epsi-workshop/server-backend/README.md

# server-backend
(Python ou C++) : API REST / WebSockets / gRPC, modèles d'IA, logique métier, requêtes base de données.
