epsi-workshop/server-backend/enclosure/stl/back.stl

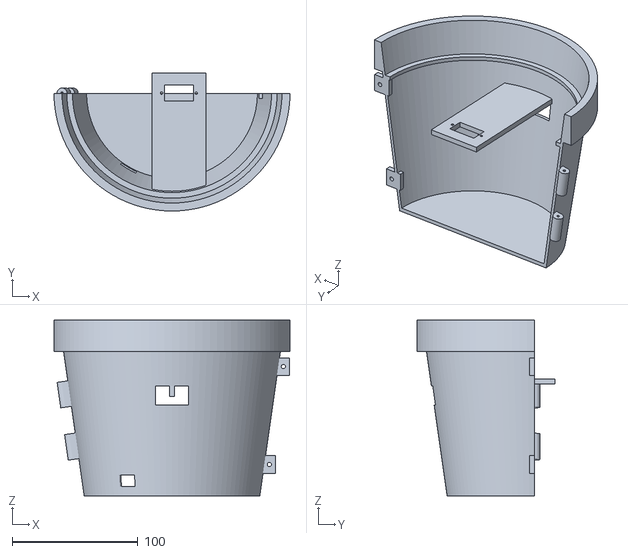
[picture p1: CAD file, 2026-10-08]
enclosure/stl/back.stl
188.0 x 110.0 x 140.0
