epsi-workshop/server-backend/enclosure/stl/tray.stl

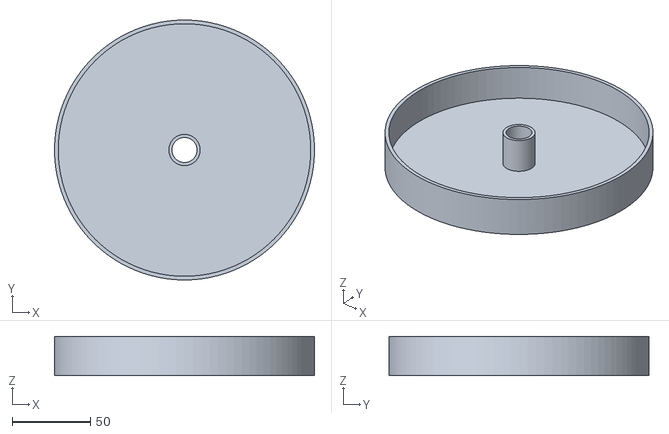
[picture p2: CAD file, 2026-10-08]
enclosure/stl/tray.stl
166.3 x 166.3 x 25.0
