epsi-workshop/server-backend/enclosure/stl/rod.stl

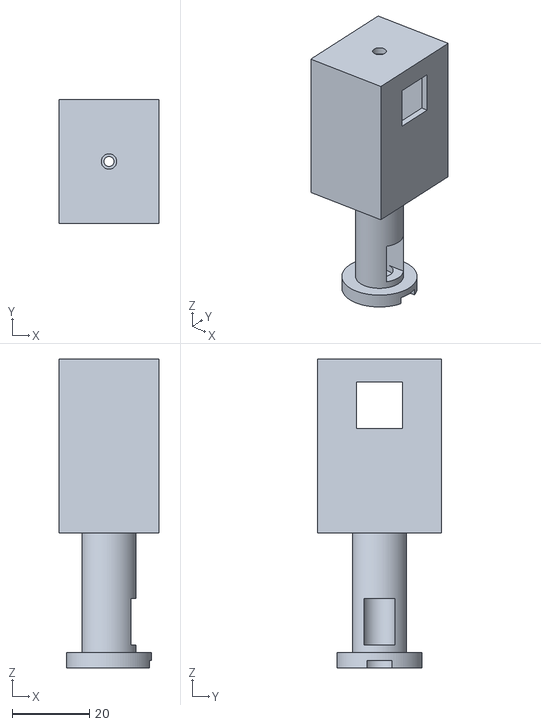
[picture p3: CAD file, 2026-10-08]
enclosure/stl/rod.stl
26.0 x 32.0 x 80.0
