epsi-workshop/server-backend/enclosure/stl/front.stl

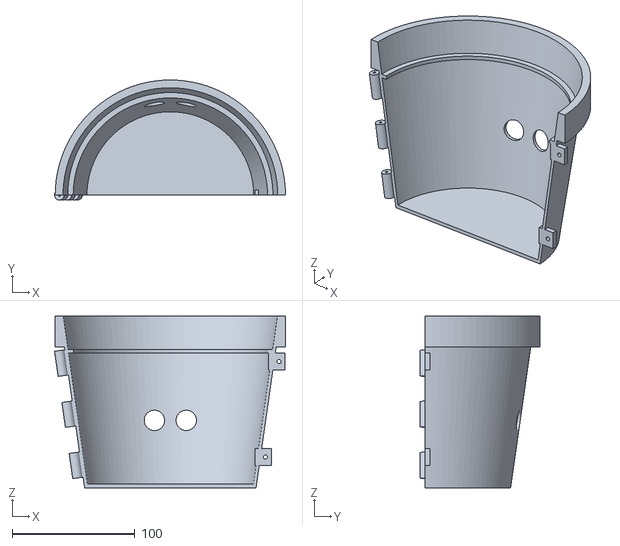
[picture p4: CAD file, 2026-10-08]
enclosure/stl/front.stl
188.6 x 98.0 x 140.0
