epsi-workshop/server-backend/enclosure/montage-3d.html

Coupe Vue éclatée Balayage caméra Rotation Recentrer

Cotes en mm · pot Ø 230 × 230

Survolez une pièce pour son nom

# Montage du pot Sentinel

Un pilier central porte la plateforme végétale et le servo. Le bras du servo sort par une fenêtre du pilier et fait tourner la caméra dans l'anneau entre la plateforme et le bord du pot.

Pot Ø 230 × 230 Pilier Ø 50 × 185 Anneau caméra 34 mm Balayage 180°

## Étapes de montage

← Étape précédente Étape suivante → Tout afficher

## Pièces de la maquette

SamseActionDéjà làÀ commander

## Points d'attention

Anneau de la caméra. L'ESP32-CAM fait 27 × 40 mm et environ 12 mm d'épaisseur : il faut au moins 30 mm entre le bord de la soucoupe et la paroi. Choisissez la soucoupe 6 à 8 cm plus petite que le diamètre intérieur du pot.

Balayage de 180°. Le SG90 ne tourne que sur un demi-tour : la caméra couvre l'avant du pot, d'où la fenêtre sur la moitié avant du pilier. Pour un tour complet, il faudrait un moteur pas à pas 28BYJ-48 et un capteur de position.

Badge. Le lecteur RC522 se colle contre la paroi intérieure : il lit à travers 2 à 3 mm de plastique. Marquez la zone à l'extérieur avec un petit autocollant.

Porte. Le capteur HW-201, fixé sous la plateforme, regarde le fond du pot : pilier soulevé = porte ouverte sur le dashboard.
