epsi-workshop/server-backend/esp32cam/secrets.h

// Remplis avec le Wi-Fi utilisé par l'UNO Q (partage de connexion de ton téléphone).
// Attention : l'ESP32 ne supporte que le 2,4 GHz.
#define WIFI_SSID     "NOM_DU_WIFI"
#define WIFI_PASSWORD "MOT_DE_PASSE"
