epsi-workshop/server-backend/(commit log)

2026-10-06 Vision : suivi du mouvement par le servo de l'UNO Q
    - tracking.py : la caméra pivote vers la plus grande zone en mouvement
    (écart au centre converti en angle, zone morte, gain, une rotation par seconde au plus)
    - Détection gelée pendant la rotation puis fond réappris à la nouvelle position
    (MotionDetector.relearn), état « mouvement » conservé pour ne pas couper l'alerte
    - Retour au repos au démarrage et après TRACK_HOME_AFTER_S sans mouvement
    - Commandes envoyées dans un thread (POST /servo/{angle}), servo injoignable = caméra fixe
    - Flux annoté : angle de suivi et croix sur la zone suivie
    - Réglages SERVO_API_URL et TRACK_*, documentés dans le README ; 9 tests
    Co-Autho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
2026-10-06 Dashboard : refonte épurée et premium, objets 3D en céramique
    - Fonds pleins noir ou blanc chaud, bascule de thème (préférence système par défaut)
    - Typographie Fraunces (chiffres, titres) et Inter ; sauge, ocre et terre cuite pour les états
    - Objets 3D three.js (un seul canvas, drei View) : logo bouclier et feuille, galet d'état,
    icônes des capteurs en céramique émaillée et métal brossé, reflets d'environnement générés localement
    - Panneau « Pot sentinelle » : modèle 3D du boîtier camouflé, réagit au PIR et à la caméra
    - Flux caméra qui se reconnecte seul en cas d'erreur
    - Brin végétal dans la barre latérale, textes à l'esprit botanique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
2026-10-07 Pot sentinelle : porte, badge RFID à deux états, modèle 3D réel, reconnaissance faciale
    - Porte du pot (capteur infrarouge) : état relayé par l'API de l'UNO Q, journal, panneau Intégrité
    - Badge RFID : un passage arme et verrouille, le suivant désarme et déverrouille ; badge inconnu refusé.
    Module arming.py : armement unique (dashboard ou badge), poussé à l'UNO Q et resynchronisé
    - Dashboard : modèle 3D du boîtier exporté de Blender (porte ouverte / fermée selon le capteur),
    ligne Porte et Verrou dans la légende du pot
    - Reconnaissance faciale de l'équipe (vision, backend, bandeau du dashboard) ; modèles et galerie
    hors dépôt (scripts/download-face-models.sh)
    Co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
2026-10-08 Badges, page de présentation, boîtier du pot et ajustements du dashboard
    - backend : module badges.py et routes d'administration associées
    - frontend : page de présentation (landing), ajustements de l'interface et des objets 3D
    - enclosure : conception du pot (OpenSCAD, STL)
    [back.stl, front.stl, pot.scad, rod.stl, tray.stl]
2026-10-08 Ajout des fichiers restants (ESP32-CAM, copie hardware-embedded, configuration de lancement)
2026-10-09 Boîtier citrouille, landing en mode démo, capteurs retirés, déploiement UNO Q
    Boîtier 3D : la citrouille animée d'Halloween remplace le pot (modèle
    procédural). Caméra ESP32-CAM et laser cachés dans le nez ; module
    électronique posé derrière (socle, Arduino UNO Q, breadboard) avec les câbles
    qui passent sous la citrouille. Dans le dashboard, l'ensemble tourne sur
    lui-même et réagit à l'état réel (yeux, tête, mains).
    Landing : textes et repères alignés sur la citrouille ; mode démo qui
    enchaîne les chapitres en boucle (bouton ou ?demo), arrêté par l'utilisateur.
    Capteurs : ultrasons et accéléromètre retirés du dashboard et de la landing ;
    le badge RFID sert uni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
2026-10-09 Citrouille : lecteur RFID dans la tête, DHT22 sous la cape, dôme PIR visible
    Modèle 3D : le dôme blanc du détecteur PIR dépasse de l'ourlet de la cape.
    Landing : repères du lecteur RFID (dans la tête), du DHT22 (sous la cape) et
    du PIR dans le schéma des composants ; le badge se présente devant la tête.
    Dashboard : emplacements des capteurs dans la légende du boîtier.
2026-10-09 Son : alarme sur alerte critique, sortie au choix, voix « Bonjour <prénom> »
    Backend : module sound (alarme parlée + sirène 30 s sur une alerte de niveau
    critique, arrêt à l'acquittement, voix « Bonjour <prénom> » préparée à l'ajout
    ou au renommage d'un membre). Routes audio : choix de la sortie (haut-parleur
    du boîtier, enceinte Bluetooth, les deux, muet), test de la voix, sons
    « alarm » et « unknown ».
    Dashboard : réglages correspondants dans l'onglet Son de l'administration.
2026-10-09 UNO Q : son, affichage des badges et code de la carte resynchronisé
    Récupéré depuis talos, où il avait été modifié directement :
    - haut-parleur sur D5 (module MOS) : bips des badges, carillon d'un visage
    reconnu, sirène d'un intrus, joués sans bloquer la boucle ; routes
    /sound/{nom} et /sound/stop ;
    - écran : UID du badge dès la lecture, puis accepté / refusé / nouveau badge
    (route /display/badge) ;
    - RC522 : écran et lecteur réinitialisés après une chute de tension du 3,3 V ;
    - moteur de la tête de la citrouille (relais D8 et A2), routes /motor ;
    - API lancée par serve.py (IPv4 et IPv6 sur le même port).
2026-10-09 Dashboard installable comme application (PWA)
    Manifeste (nom, icônes, couleurs, raccourcis Alertes et Caméra), icônes Android,
    iPhone et favicon, balises iOS, service worker (pages en réseau d'abord avec copie
    de secours hors connexion, assets en cache, /api et /ws jamais en cache) et bouton
    « Installer l'application » dans la barre latérale. nginx (Docker et UNO Q) :
    service worker et manifeste jamais mis en cache, manifeste en
    application/manifest+json. Documentation dans frontend/README.md.
2026-10-09 UNO Q : sortie sonore au choix, voix Piper, sons alarm et unknown
    Le backend appelait /sound/alarm, /sound/unknown, /audio/output et
    /audio/voice/prepare, absents de la carte (erreur 422 dans le dashboard).
    - audio.py : sortie mémorisée (wired, bluetooth avec repli sur le boîtier,
    both, off) ; voix française hors ligne Piper (fr_FR-siwis-medium) avec cache,
    « Bonjour <prénom> », « Inconnu détecté », message d'alarme + sirène 30 s ;
    - main.py : routes /audio/output et /audio/voice/prepare, /sound/{nom} étendu,
    visage et badge joués sur la sortie choisie ;
    - sketch : set_speaker coupe le haut-parleur du boîtier quand seule
    l'enceinte doit jouer ;
    - fix-bluetooth-audio.s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
    [audio.py, main.py, sensors.ino]
2026-10-09 PWA : manifeste renommé en manifest.json
    Servi en application/json par n'importe quel nginx, sans modifier la config
    système de l'UNO Q (qui demande sudo). Service worker passé en v2 pour
    renouveler la copie de secours des pages.
2026-10-09 Voix : « Bonjour <prénom> » pour chaque membre, plus jamais le Victor enregistré
    - Carte : plus de repli sur voice-bonjour.wav (« Bonjour Victor ») quand la
    synthèse n'est pas prête ; le carillon seul est joué.
    - Backend : « Bonjour <prénom> » synthétisé à l'avance pour tous les membres
    actifs, à chaque mise à jour de la galerie (démarrage compris).
    - Dashboard : prénom au choix pour le test de voix (onglet Son), et bouton de
    test « Bonjour <prénom> » sur chaque membre de l'équipe.
    - fix-bluetooth-audio.sh : redémarre aussi le WirePlumber de lightdm.
    [audio.py]
2026-10-09 Vision : toujours analyser l'image la plus récente (10 s de retard sur la caméra)
    Sur l'UNO Q, l'analyse (mouvement + visages) est un peu plus lente que la
    caméra : les images lues une à une s'accumulaient et le flux annoté prenait
    jusqu'à une dizaine de secondes de retard. La lecture tourne maintenant dans
    son propre thread et ne garde que la dernière image ; les images en retard
    sont abandonnées (environ 3 par seconde mesurées sur talos), et leur nombre
    est journalisé une fois par minute.
2026-10-09 Captures : servir aussi celles des visages reconnus ou inconnus
    Seules les captures rattachées à une alerte étaient servies : le bandeau
    « Bonjour … » du dashboard affichait une image en 404.
2026-10-09 Alarme : seulement pour un intrus quand le système est armé
    - Déclenchement : uniquement un visage inconnu pendant que le système est
    armé (voix « Intrusion détectée » + sirène). Les autres alertes critiques
    (porte, PIR…) restent dans le dashboard, sans sirène.
    - Arrêt : visage reconnu (puis « Bonjour <prénom> »), badge valide,
    désarmement (dashboard ou badge), acquittement de l'alerte.
    - Carte : plus de son automatique à l'affichage d'un visage (la sirène de 10 s
    partait même désarmé) ; le backend décide de tous les sons de visage.
    Vérifié sur talos : intrus désarmé sans sirène ; armé par badge, intrus ->
    alarme, Victor reconnu -> arrêt + bonjour, int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
2026-10-09 Retrait du capteur de porte (HW-201), qui ne sera pas branché
    Sans capteur, l'entrée D4 lisait « ouverte » : chaque redémarrage journalisait
    « Capot du boîtier ouvert » et créait une alerte « Sabotage du boîtier ».
    - Carte : lecture de D4, simulation et méthodes Bridge get_lid / set_lid_sim
    retirées ; l'écran n'affiche plus « PORTE OUVERTE ». API : routes /sensors/lid
    et champ « lid » de /sensors retirés.
    - Backend : événement lid_open, état lid, signal et poids « capot » retirés ;
    « Sabotage du boîtier » ne dépend plus que du choc.
    - Dashboard et présentation : panneau Capot, légende, poids et mentions du
    capteur retirés (l'animation 3D du couvercle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
2026-10-09 Interface mobile : dashboard, backoffice et landing
    Dashboard : barre d'onglets en bas de l'écran, en-tête compact collant,
    bandeau de menace sur deux lignes, notifications au-dessus des onglets,
    champs à 16 px (pas de zoom iOS), tableaux en cartes empilées (journaux,
    services, comptes, badges), graduations de l'historique sans doublons.
    Backoffice : onglets sur une ligne défilante, bouton d'enregistrement pleine
    largeur, lecteur de badge et formulaires empilés.
    Landing : en-tête compact (démo en icône), citrouille dans le tiers haut,
    textes resserrés, repères réduits à des points et liste compacte des
    composants.
